plusvic/simplebus2-intercom/remote_unit_v2/cyw43-firmware/README.md

# WiFi + Bluetooth firmware blobs

Firmware obtained from https://github.com/georgerobotics/cyw43-driver/tree/main/firmware

Licensed under the [Infineon Permissive Binary License](./LICENSE-permissive-binary-license-1.0.txt)
