plusvic/simplebus2-intercom/(threads)

Thread 2 (2021-11-08):

PCB

thomasvt1, 2021-11-08:
Hey, this looks awesome! I was just wondering, did you make the PCB yourself or did you create/build/assemble is somewhere?

simplebus2-repeater.kicad_pcb seems to be empty so jlcpcb.com seems to be a no-go

plusvic, 2021-11-08:
I built the PCB using a soldering breadboard, didn't printed a proper PCB.

FilippoPiazza, 2023-01-26:
Can you show the pcb? It's not seen in the pictures

Elektroarzt, 2023-02-05:
If someone is interested, I made an Eval-Board for easy measurement of power and some key signals with an additional connection possibility to a D1 mini. If needed I could upload the Gerber data. If someone has a software solution for a D1 mini or ESP32, I would be grateful to participate and could adapt to the pub design.

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

Elektroarzt, 2023-05-11:
Hi [VideoScape](https://github.com/VideoScape),
please be aware, that this PCB is work in progress and is no plug-and-play solution. If you like to participate in developing, this could be a good starting point. I could send you a unit with schematics for self-cost, please give me an e-mail to handle this. In return I would like to participate in your findings and an ESP-based firmware if you plan to do so.
As plusvif already stated, the linear power supply is not sufficient for the ESP. Not the S2 bus voltage is dropping, but the thermal protection of the linear power regulator. Would be better to use a step-down-converter. The PCB gives you all possibilities for that.

richardneitzke, 2023-05-14:
Hi @Elektroarzt!

Looks like you've already made some progress on the hardware-side, I'm currently looking into building an ESP8266/ESP32-based bridge as well but I just got started (had a look at the signals with my scope today).

My initial plan for drawing power from the bus was to use one of these cheap LM2596 boards I have lying around but connecting one killed the bus (even without drawing any current, maybe it's the capacitor across the input). What do you use for power on your board?

Elektroarzt, 2023-05-16:
Using the linear regulator with the ESP results in brownouts, so I also used a LM2596 but had no issues with the bus at first sight. Did you connect behind the low pass filter like in plusvic's schematic?
I think Gurkenflieger is miles ahead with his ESP development approach: https://github.com/plusvic/simplebus2-intercom/issues/5. Maybe this will be the better path.

Gurkenflieger, 2023-05-23:
![Uploading AC360B84-6A4E-4699-9CF6-66F649A49109.jpeg…]()

Gurkenflieger, 2023-05-23:
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

issalig, 2023-10-04:
@Elektroarzt would you mind to share your pcb/software? My idea is to connect an ESP32 or even a RPIZero to manage the video/audio and not start from zero if possible.

Elektroarzt, 2023-10-04:
I had some really productive and funny hours of teamwork with [Gurkenflieger](https://github.com/Gurkenflieger) on this project. Outcome was a V2.0 of the PCB and a newly coded software for Comelit systems based on [plusvics](https://github.com/plusvic) work. We had the plan of publishing to a GitHub, but had not the time until today. I talked to [Gurkenflieger](https://github.com/Gurkenflieger) concerning the video option. From what we see, this function could be solved in best case with a Piggy-Back on the V2.0 PCBA (see picture J2 and J3). It is populated with a Seeedstu
dio XIAO ESP32C3 wich should be potential enough for this task. Please be patient until we have the time to publish.

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

issalig, 2023-10-04:
It looks great.
The problem to read the video is not the power of a ESP32 (that I think is capable) but to implement CVBS capture, that's why I was thinking on using a rpi zero and usb capturer.
Anyway, I will stay tun

quentinjourdan, 2024-01-09:
> I had some really productive and funny hours of teamwork with [Gurkenflieger](https://github.com/Gurkenflieger) on this project. Outcome was a V2.0 of the PCB and a newly coded software for Comelit systems based on [plusvics](https://github.com/plusvic) work. We had the plan of publishing to a GitHub, but had not the time until today. I talked to [Gurkenflieger](https://github.com/Gurkenflieger) concerning the video option. From what we see, this function could be solved in best case with a Piggy-Back on the V2.0 PCBA (see pin headers J2 and J3 in the following pictures). It is populated with a Seeedstudio XIAO ESP32C3 wich should be potential enough for this task. Please be patient until we have the time to publish.
>
> ![Mittel (Simplebus MQTT Bridge V2 0 Pic4)](https://private-user-images.githubusercontent.com/61664171/272495760-3bd765ca-6ebf-4322-bf2a-cff87bbcb585.jpeg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) ![Mittel (Simplebus MQTT Bridge V2 0 Pic5)](https://private-user-images.githubusercontent.com/61664171/272495755-86c3be73-529c-4ac1-ac80-a8bd9ae055a9.jpeg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) ![Mittel (Simplebus MQTT Bridge V2 0 Pic2)](https://private-user-images.githubusercontent.com/61664171/272495763-15ea2756-d622-4c0f-a23b-1a509d0defcf.jpeg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) ![Mittel (Simplebus MQTT Bridge V2 0 Pic3)](https://private-user-images.githubusercontent.com/61664171/272495762-59028f65-c8ad-4aa8-b1d2-61a8ed68e56d.jpeg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) ![Mittel (Simplebus MQTT Bridge V2 0 Pic1)](https://private-user-images.githubusercontent.com/61664171/272495767-805a1d74-fb70-4405-b2b5-fb315aa98c77.jpeg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)

Incredible @Elektroarzt  @Gurkenflieger, do you plan to release the code/pcb files or kit ? I’m very interested for my appartement

Elektroarzt, 2024-01-11:
> Incredible @Elektroarzt @Gurkenflieger, do you plan to release the code/pcb files or kit ? I’m very interested for my appartement

I'm uploading hardware and mechanics right now to an own GitHub page. What do you need for the start? It's a bit more stuff. In V2.0 of the PCB there was a pinout bug that had to be routed by hand. I made a V2.1 PCB, that I have to test the next days. Therefor I will make a small batch of V2.1 if you are interested in a kit.
Software was coded by @Gurkenflieger, who will upload shortly.

se-bastiaan, 2024-01-12:
> Therefor I will make a small batch of V2.1 if you are interested in a kit.

If you end up doing this, definitely let me know :)

richardneitzke, 2024-01-13:
Same here, I’d love to buy a kit!

Elektroarzt, 2024-01-18:
I don't want to spam this issue. So if you are interested in the above spinoff project, go to [this](https://github.com/Elektroarzt/simplebus2-mqtt-bridge/tree/main) project page. I will open up an issue there for the PCBA to keep you in the loop.
A lot of thanks for the great work so far go to @plusvic!

Closed 2024-01-11.

Thread 3 (2022-03-29):

PIC12F508

pcalabrese, 2022-03-29:
Hi!,
Very helpful and complete protocol description! Congrats!!

I was wondering if the PIC12F508 can be more easily replaced with a ESP8266 or other chip easier to find / program.

I've read about your first prototypes with 433MHz transceiver and/or ESP8266. Could you share more details about?

Still Many Thanks for your great job!

plusvic, 2022-03-30:
Hi, in theory you can replace the PIC12F508 with an ESP8266, but it would a new program for decoding the signal and probably a new circuit. The ESP8266 is a lot more power hungry than the PIC12F508, that's why I ended up using the latter.

My tests with the ESP8266 where very limited, I just tried to power it from the intercom line, but it dropped the voltage too much, so I decided to switch to the PIC12F508. In theory it could be done, as the intercom line is able to power much larger devices with video screens, which require a lot of power, but I'm not an electronics expert didn't know how to do it properly.

Gurkenflieger, 2023-01-21:
Hello, do you still have your code from the ESP testing? I think that the voltage regulater overheats and it could be possible to implement a buck converter to drive an esp.

plusvic, 2023-01-23:
I didn't wrote the code for the ESP, I dropped the idea of using ESP very early in the design phase.

Thread 4 (2022-06-29):

Need some explanation

Elektroarzt, 2022-06-29:
Hi plusvic,

I like to use your fabulous work in a similar project (S2 bus > ESP8266 > Node Red > Apple HomeKit). Now I have some questions, that you maybe can answer:
- the PIC is not available til end of the year in Germany, is it possible to direct replace with a 12f509?
- as I understand, the UART speaks out the codes in your table, so the ESP8266 UART will fit seamless, correct?

Best regards and thanks in advance,
Thomas

plusvic, 2022-06-30:
Hi Thomas,

The only difference between the PIC 12F508 and the 509 is that the latter has more memory, so you can use it without changes in the code.

The UART speaks out the same 18-bits messages transmitted over the bus, including message id, destination address and checksum. Each message is encoded in 3 bytes when transmitted over UART. The transmissions is done at 4800 bauds, so you must configure the ESP8266 to receive at that speed.

You can see how each part of the message is decoded from the 3 bytes received over UART in https://github.com/plusvic/simplebus2-intercom/blob/main/remote_unit/src/main.cpp#L362

You will need an equivalent code for your ESP8266.

Elektroarzt, 2022-09-01:
Would it be possible for you to generate a hex file? I installed the microchip IDE but I'm experiencing lots of problems in compiling the asm file. This would be very helpful, as I am more the hardware guy. I made a PCBA out of your schematic if you or someone else is interested.

Many thanks in advance!

plusvic, 2022-09-06:
I lost the Virtual Machine where I had all the setup for building the code and generating the hex file, it would be very time-consuming for me and don't have too much time to spend on this project anymore.

Closed 2022-09-06.

Thread 5 (2023-01-26):

PIC12F508 Hex file

Gurkenflieger, 2023-01-26:
Is it possible to receive the hex file of the asm programm? PIC Programming is new to me and converting this to an Hex file in order to flash it through a K150 flasher is not straight forward unfortunately.

plusvic, 2023-01-26:
Unfortunately I don't have the hex file around.

Gurkenflieger, 2023-02-03:
Thanks, i managed to power an esp32 with a polulu 5v 1A DC DC converter.

Gurkenflieger, 2023-02-03:
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

plusvic, 2023-02-03:
The trick is measuring the time that elapses from one pin change to the other. You need to measure for how long the pin remains without changes. When that interval is around 17ms you have detected the message preamble. If you see an interval around 3ms without pin changes that's a 0, while 6ms it's a 1.

Shorter intervals, like the ones seen during the 25khz burst, are simply ignored. Every time the pin changes you simply reset the time counter. The important thing about the protocol is the time that elapses without pin changes, that's what you need to measure, and see if the interval fits any of the expected values (17ms, 6ms or 3ms)

Gurkenflieger, 2023-02-07:
Thanks, now i can send and receive messages directly with the esp 32 but if ringing outside i only receive the Acknowledgment pulses without a proper preamble and message. So i’m detecting an outside ring if there was no message and only 3 short pulses .
I think the Intercom activates over the Video, because if i ring with the CFP button (which does not activate the video) i receive the correct corresponding message with the preamble (17 ms pausetime).

Thank you for your previous help!

plusvic, 2023-02-07:
It looks like the signal that arrives to you when someone rings outside is too weak, and falls below the threshold voltage for the LM2903. The LM2903 is acting as a voltage comparator between a fixed voltage of 500mV and the pulses that conform the signal. If the pulses are below 500mV they won't trigger the comparator. When you use the CFP button the signal is generated by your own intercom. That signal is stronger because the source is closer, and the peak voltages are higher. The same happens when you push the "open door" button in the intercom, the signal is very strong because it's generated by the intercom itself.

In the images you posted the signal has peaks around 1.2V, but the message code is "open door", so you probably generated that image by pushing the "open door" button in your home's intercom. If the strong signal coming from the closer intercom has ~1.2V peaks, you can expect the weaker signal coming from the intercom in the street to be way lower,
probably 1/3 of that, or 400mV.

What you can do is replacing either R3 or R4 in the [diagram](https://user-images.githubusercontent.com/182937/119274823-27513a00-bc12-11eb-81a5-44e7b55a2baf.png
) with a potentiometer. The potentiometer will allow you to adjust the voltage at pin 2 of LM2903, in your case you need to make the voltage lower, probably around 250-300mV. You don't want go too low neither, because then your signal will be affected by noise in the line.

You can try to capture with the oscilloscope the signal generated when someone rings outside, in order to be able to measure the peaks in a the signal. Of your may find the appropriate threshold voltage by trial and error, lowering the voltage a little bit until your device is able to see the signal.

Gurkenflieger, 2023-02-08:
Thanks, that helped! I used a 6k8 R4 and i can now see the ring on my oszi and in my application. Thanks alot. I also put a high pass filter on the input of the NPN transistor to prevent a long short on the bus. I have seen this on an other implementation of the simplebus 1 protocol.

plusvic, 2023-02-08:
Great! The high pass filter looks like a great design improvement. If I understand correctly you put a capacitor in between R5 and Q1, right?

Gurkenflieger, 2023-02-08:
I put the same values as C3 and R2 from the controller output to GND. Between the capacity and resistor the transistor is connected. I think if C3 and R2 are passing through the 25khz signal the values should be fine.

plusvic, 2023-02-10:
As long as you are getting a stable DC voltage at the output of the 7805 it should be fine. You can also increase the capacity of C1, that should compensate the decrease of R1.

Elektroarzt, 2023-05-11:
> I also noticed some brownouts, but the problem was the resistor value of the low pass filter. This resistor was getring pretty hot. I exchanged it for a 2.2 Ohm Resistor to minimize the voltage drop and heat buildup. With the 510 Ohm resistor and 3W power consumption of the esp, the voltage drop was massive. But the filtering is now a little worse. But still the values should filter all signals above 300Hz. What do you think ?

Gurkenflieger, do you have the described solution up and running for outside / inside ringing in your setup with ESP32?

Gurkenflieger, 2023-05-13:
Yes but i put  diode in instead of an resistor and im using 3.3V for the more efficient supply. The ESP 32 works and has no brownouts but the reference voltage of the comparator drops and therefore i cant detect a outside ring. I have to get a better scope to fix this. I also have some PCBS made for this application which fit under the intercom in the 68mm hole.
My Code works perfectly if i supply the ESP32 Externally. But at the moment my time is limited and i will rework on this in the near future.
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

Gurkenflieger, 2023-05-16:
> > I also noticed some brownouts, but the problem was the resistor value of the low pass filter. This resistor was getring pretty hot. I exchanged it for a 2.2 Ohm Resistor to minimize the voltage drop and heat buildup. With the 510 Ohm resistor and 3W power consumption of the esp, the voltage drop was massive. But the filtering is now a little worse. But still the values should filter all signals above 300Hz. What do you think ?
>
> Gurkenflieger, do you have the described solution up and running for outside / inside ringing in your setup with ESP32?

So after my initial feedback i just bought a new oscilloscope with way more memory and im able to debug the system in the coming weeks. Will post my results and my schematics.

Elektroarzt, 2023-05-16:
Your board looks awesome, nice idea to put it in the junction box. Would be happy to hear from your findings :)

issalig, 2023-10-04:
> So after my initial feedback i just bought a new oscilloscope with way more memory and im able to debug the system in the coming weeks. Will post my results and my schematics.

@Gurkenflieger , is it possible for you to share your code and pcb? I want to do the same and it would save me a lot of time. No matter if I need to power it externally.

Thread 7 (2023-05-24):

Audio/Video protocol

gizahNL, 2023-05-24:
Do you have a description of the A/V protocol that is used on simplebus2? Would be really cool to hack together a device that can hook into the A/V stream & relay it onto my network.

plusvic, 2023-05-25:
The A/V signal is analog, not digital. It looks like some kind of [composite video](https://en.wikipedia.org/wiki/Composite_video), but I'm not sure whether its PAL, NTSC or SECAM. My expertise in that area is close to null. I had the idea of decoding the A/V signal too, but after some investigation I concluded that my knowledge about analog electronics is too limited for such undertake. If anyone with more experience can make some progress on that it would be great.

plusvic, 2023-05-25:
See #6.

issalig, 2023-10-02:
I was able to see the image with just a cheap USB video capturer. You only need gnd and as far as i remember the composite signal is the yellow cable that goes to the screen.

plusvic, 2023-10-03:
@issalig that's very interesting, can you share more details about your setup?

issalig, 2023-10-03:
I have re-opened the intercom and yes, it is the yellow cable that goes to the CVBS in the pcb silkscreen.
Upper left connector
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

morganflint, 2024-03-29:
Hello, great project!
I understand capturing and streaming the video with cheap devices like ESP32 might be nearly impossible but, what about just audio?
It must be possible to do it directly from the simplebus2 signal, as the Ring device does (bilateral)... but maybe the associated hardware isn't simple

Elektroarzt, 2024-03-29:
Hi ... for the basic communication part of the S2 bus except audio / video we have a solution, but audio would be very interesting. Here is a [link to an issue of a spinoff project](https://github.com/Elektroarzt/simplebus2-mqtt-bridge/issues/3), where sashahilton00 documented his investigations concerning audio so far. Maybe it helps or is a start.

Thread 8 (2023-10-03):

Board headers

issalig, 2023-10-03:
I have detected this headers in the board J5 that looks an I2C bus and J5 for mcu programming.
It would be interesting to explore J5.

Also, I am thinking if TP12 and TP13 Rx and TX would show the  messages in 0-5V

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

mmhobi7, 2024-07-26:
Any updates?

Thread 9 (2023-11-25):

Capacitors types and values

prtngrm, 2023-11-25:
Hi,
I would like to make this project but I'm not an electronic expert.
Could someone tell what is the type and voltage values of each capacitor?

Also which type of diodes for the full bridge rectifier?

plusvic, 2023-11-25:
C1 and C2 are electrolytic capacitors, C3 is a ceramic capacitor.

Values are in the [schematic](https://user-images.githubusercontent.com/182937/119274823-27513a00-bc12-11eb-81a5-44e7b55a2baf.png)

C1 = 150 microF
C2 = 220 microF
C3 = 100 nanoF

For the diodes the 1N4001 or 1N4002 should work fine.

prtngrm, 2023-12-05:
Thanks !

Closed 2023-11-25.

Thread 10 (2024-02-02):

Irrelevant data received

prtngrm, 2024-02-02:
Hi,
I made the repeater based on the schematic. For the remote unit I use an esp32.
At first I wasn't receiving anything. Then I tweaked the remote unit code to print all messages and that worked except that the message codes wasn't like yours and the checksum received didn't match the calculated one.
I was on a breadboard so I soldered the repeater on a perf board but that didn't solve the problem.
I tried to make my intercom ring with a button for the test with no luck.
Here is an example of what I have with the calculated checksum and the received:
```
RX <- code: 191 address: 254 checksum: 14 checksum received: 15
RX <- code: 191 address: 14 checksum: 10 checksum received: 0
RX <- code: 246 address: 15 checksum: 10 checksum received: 0
RX <- code: 255 address: 15 checksum: 12 checksum received: 0
RX <- code: 2 address: 0 checksum: 1 checksum received: 0
RX <- code: 0 address: 232 checksum: 4 checksum received: 15
RX <- code: 3 address: 0 checksum: 2 checksum received: 0
RX <- code: 191 address: 14 checksum: 10 checksum received: 14
RX <- code: 163 address: 254 checksum: 11 checksum received: 14
RX <- code: 191 address: 142 checksum: 11 checksum received: 14
RX <- code: 3 address: 0 checksum: 2 checksum received: 0
RX <- code: 3 address: 12 checksum: 4 checksum received: 14
RX <- code: 254 address: 15 checksum: 11 checksum received: 0
RX <- code: 248 address: 31 checksum: 10 checksum received: 12
RX <- code: 255 address: 15 checksum: 12 checksum received: 0
RX <- code: 2 address: 0 checksum: 1 checksum received: 0
RX <- code: 191 address: 14 checksum: 10 checksum received: 14
RX <- code: 131 address: 254 checksum: 10 checksum received: 14
RX <- code: 191 address: 142 checksum: 11 checksum received: 14
RX <- code: 3 address: 0 checksum: 2 checksum received: 0
RX <- code: 3 address: 0 checksum: 2 checksum received: 0
RX <- code: 132 address: 14 checksum: 5 checksum received: 0
RX <- code: 0 address: 20 checksum: 2 checksum received: 14
RX <- code: 132 address: 14 checksum: 5 checksum received: 0
RX <- code: 135 address: 10 checksum: 6 checksum received: 0
RX <- code: 131 address: 254 checksum: 10 checksum received: 14
RX <- code: 191 address: 14 checksum: 10 checksum received: 14
RX <- code: 131 address: 254 checksum: 10 checksum received: 14
RX <- code: 138 address: 10 checksum: 5 checksum received: 0
RX <- code: 3 address: 0 checksum: 2 checksum received: 0
RX <- code: 11 address: 12 checksum: 5 checksum received: 0
RX <- code: 144 address: 14 checksum: 5 checksum received: 0
RX <- code: 191 address: 142 checksum: 11 checksum received: 14
RX <- code: 131 address: 254 checksum: 10 checksum received: 14
RX <- code: 191 address: 14 checksum: 10 checksum received: 14
RX <- code: 3 address: 0 checksum: 2 checksum received: 0
RX <- code: 154 address: 10 checksum: 6 checksum received: 0
RX <- code: 155 address: 10 checksum: 7 checksum received: 0
RX <- code: 25 address: 108 checksum: 7 checksum received: 14
RX <- code: 191 address: 142 checksum: 11 checksum received: 14
RX <- code: 131 address: 254 checksum: 10 checksum received: 14
RX <- code: 191 address: 142 checksum: 11 checksum received: 14
RX <- code: 3 address: 0 checksum: 2 checksum received: 0
```

When I call from the building:
```
RX <- code: 84 address: 5 checksum: 5 checksum received: 0
RX <- code: 150 address: 10 checksum: 6 checksum received: 0
RX <- code: 255 address: 15 checksum: 12 checksum received: 14
RX <- code: 131 address: 254 checksum: 10 checksum received: 14
RX <- code: 191 address: 14 checksum: 10 checksum received: 0
```
My address is 5.

plusvic, 2024-02-03:
It's hard to say what's happening there. Without an oscilloscope that allows you to see if the signal you are receiving is ok, you will have a hard time debugging this.

Thread 11 (2024-11-29):

Opening a secondary entrance door

m4rcu5, 2024-11-29:
On my Comelit intercom I can control multiple doors. Without the screen turned on, hotting the "open" button wil open the primary entrance. However if I cycle through the camera feeds by pressing "1", I can open the secondary entrance when its in view by pressing the same "open" button.
Does anyone have experience with the codes this spits out?

I haven't build a module yet, as I was hoping for some experiences first, but otherwise I'll just go build, play, and report back :)

plusvic, 2024-11-29:
In my case it's very similar, but only with two doors. The codes for opening each door is the same regardless of the door you are opening. The intercom in your house simply sends the "open door" message through the wire, and the door intercom that is active at that moment is the one that actuates and opens the door asigned to it. The rest of the doors receive the message too, but they don't open their door because they are not active at that moment.

m4rcu5, 2024-11-30:
That interesting! In my case, I have a Comelit 6701W, where button "2" (sorry mistyped in the original message) is set to "self activation". If you press it, it will activate the camera/mic of the main entrance. And when pressed again cycles to the next door.

So I suspect that this "activates" the door, which will then listen to the "open" call. As far as I understand the system, the video signal is analog, and therefore allows only a single intercom to be active at the same time.

The use-case of responding to a call by opening the door would work out of the box. But my use-case would be more the other way around, opening the door from my phone, as a way of key-less entry.

Taken that the secondary door was added at a later stage, and did not require reconfiguration of my unit, I don't see the indoor unit send a addressed call to it directly. Meaning the button would send some sort of "cycle" code?
I did notice, it will always start with the first door when pressing the "self-activate", and just continue to cycle when pressed.

Is there a way to monitor for the raw codes send on the line?

plusvic, 2025-02-01:
@m4rcu5 I just discovered the answer to your question by accident. The secondary door is activated my sending the "camera on" (code 20) message twice in a short interval (around 1s). I guess that if you have a third camera it could be activated by sending the message 3 times in short intervals.

m4rcu5, 2025-02-05:
> [@m4rcu5](https://github.com/m4rcu5) I just discovered the answer to your question by accident. The secondary door is activated my sending the "camera on" (code 20) message twice in a short interval (around 1s). I guess that if you have a third camera it could be activated by sending the message 3 times in short intervals.

Thanks for testing! I take it you need send the code 20 twice, followed by the 'door open' code. I'll start gathering some hardware and build the circuit to test :)

Thread 12 (2025-01-15):

Display gray scale in colour monitor.

polpas, 2025-01-15:
Hi there,

I have a monochrome 5801 monochrome device aka b&w. I installed an 6721w but having image interference. Does anyone know if I can apply any kind of filter so image does not get with interference?

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
