plusvic/simplebus2-intercom/repeater/pcb/simplebus2-repeater.kicad_pcb

## KiCad design sensor_node_PCB/sensor_node_PCB.kicad_pcb


Parts:
C1, C5: 0.1 uF; C_0603_1608Metric
C2, C4: 47uF; C_0603_1608Metric
C3, C10: 1uF; C_0603_1608Metric
C6: 4.7uF; C_0603_1608Metric
C12, C13: C_Small; C_0603_1608Metric
D1: DIODE; D_SOD-123
D2: LED; LED_0603_1608Metric
F1: Polyfuse; Fuse_1206_3216Metric
J1: USB_B_Mini; USB_Mini-B_Tensility_54-00023_Vertical
J3: OUTPUT_CONNECTOR; PhoenixContact_MSTB_2,5_4-GF-5,08_1x04_P5.08mm_Horizontal_T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
P1: BREAKOUTS; TerminalBlock_bornier-6_P5.08mm
Q1: FDN340P; SuperSOT-3
Q2, Q3: BSS138; SOT-23
R1, R2, R6, R7, R8, R9: 10K; R_0603_1608Metric
R3: 510; R_0603_1608Metric
R4, R5: 27R; R_0603_1608Metric
R10: 1k; R_0603_1608Metric
U1: LMV358IDGKR; SOIC-8_3.9x4.9mm_P1.27mm
U2: LD1117S50TR; SOT-223-3_TabPin2
U4: LM1117-3.3; SOT-223-3_TabPin2
U6: SP485EEN-L_TR; SOIC-8_3.9x4.9mm_P1.27mm
U7: sensair_s8; senseair_s8_v3
U8: BME280; Bosch_LGA-8_2.5x2.5mm_P0.65mm_ClockwisePinNumbering
U9: sht20; DFN-6-1EP_3x3mm_P1mm_EP1.5x2.4mm
U10: dps310; Bosch_LGA-8_2x2.5mm_P0.65mm_ClockwisePinNumbering

Connections:
3V3_LDO: C6.1, C10.1, Q2.1 (G), Q3.1 (G), R6.1, R7.1, U1.2 (-), U4.2 (VO), U8.2 (CSB), U8.6 (VDDIO), U8.8 (VDD), U9.5 (VDD), U10.6 (VDDIO), U10.8 (VDD)
5V_LDO: C1.2, C3.1, C4.1, C5.1, P1.1, Q1.2 (S), R3.2, R8.1, R9.1, U1.8 (V+), U2.2 (VO), U4.3 (VI), U6.8 (VCC), U7.1 (G+(5V)); also elsewhere on the board
12V_BUS: D1.2 (A), J3.4
/ARD_RX1: U6.1 (RO); also elsewhere on the board
/ARD_RX2: U7.7 (UART_TxD); also elsewhere on the board
/ARD_SCL: Q2.3 (D), R8.2; also elsewhere on the board
/ARD_SCL_3V3: Q2.2 (S), R6.2, U8.4 (SCK), U9.6 (SCL), U10.4 (SCK)
/ARD_SDA: Q3.3 (D), R9.2; also elsewhere on the board
/ARD_SDA_3V3: Q3.2 (S), R7.2, U8.3 (SDI), U9.1 (SDA), U10.3 (SDI)
/ARD_TX1: U6.4 (DI); also elsewhere on the board
/ARD_TX2: U7.6 (UART_RxD); also elsewhere on the board
/MODBUS_A-: J3.3, U6.6 (A)
/MODBUS_B+: J3.2, U6.7 (B)
/RS485_LINE_EN!: U6.2 (*RE), U6.3 (DE); also elsewhere on the board
/USB_D+: R4.1; also elsewhere on the board
/USB_D-: R5.1; also elsewhere on the board
/atmega328p/ARD_AN0: P1.6; also elsewhere on the board
/atmega328p/ARD_DIG6: P1.5; also elsewhere on the board
/atmega328p/ARD_DIG7: P1.4; also elsewhere on the board
/atmega328p/ARD_DIG9: P1.3; also elsewhere on the board
GND: C1.1, C2.2, C3.2, C4.2, C5.2, C6.2, C10.2, C12.2, C13.2, D2.1 (K), J1.5 (GND), J1.6 (Shield), J3.1, P1.2, R2.1, U1.4 (V-), U2.1 (GND), U4.1 (GND), U6.5 (GND), U7.2 (G0(GND)), U8.1 (GND), U8.5 (SDO), U8.7 (GND), U9.2 (Vss), U9.7 (NC_3), U10.1 (GND), U10.7 (GND); also elsewhere on the board
unnamed 32: C12.1, C13.1, R10.1; also elsewhere on the board
unnamed: D2.2 (A), R3.1
unnamed: F1.2, J1.1 (VBUS)
unnamed: J1.2 (D-), R5.2
unnamed: J1.3 (D+), R4.2
unnamed: Q1.1 (G), U1.1
unnamed: R1.1, R2.2, U1.3 (+)
unnamed 41: R10.2; also elsewhere on the board
USBVCC: F1.1, Q1.3 (D)
Vin: C2.1, D1.1 (K), R1.2, U2.3 (VI)


Parts:
C7, C11: 0.1 uF; C_0603_1608Metric
C8, C9: 18pF; C_0603_1608Metric
D3: LED; LED_0603_1608Metric
D7: 1N4148W-7-F; D_SOD-123
ICSP2: M20-9980346; PinHeader_2x03_P2.54mm_Vertical_SMD
R11: R_Small; LED_0603_1608Metric
R12: 1K; R_0603_1608Metric
R13: 0; R_0603_1608Metric
R16: 10K; R_0603_1608Metric
U5: ATmega328P-AU; TQFP-32_7x7mm_P0.8mm
Y1: Crystal; Crystal_SMD_5032-2Pin_5.0x3.2mm

Connections:
5V_LDO: D7.2 (A), ICSP2.2, R16.2, U5.4 (VCC), U5.6 (VCC), U5.18 (AVCC); also elsewhere on the board
328P_ICSP_MISO: ICSP2.1, U5.16 (PB4)
328P_ICSP_MOSI: ICSP2.4, U5.15 (PB3)
328P_ICSP_SCK: ICSP2.3, U5.17 (PB5)
/ARD_RX1: U5.32 (PD2); also elsewhere on the board
/ARD_RX2: U5.2 (PD4); also elsewhere on the board
/ARD_SCL: U5.28 (PC5); also elsewhere on the board
/ARD_SDA: U5.27 (PC4); also elsewhere on the board
/ARD_TX1: U5.1 (PD3); also elsewhere on the board
/ARD_TX2: U5.9 (PD5); also elsewhere on the board
/RS485_LINE_EN!: U5.12 (PB0); also elsewhere on the board
/ard_DTR: C11.1, R12.1; also elsewhere on the board
/ard_rx: U5.30 (PD0); also elsewhere on the board
/ard_tx: U5.31 (PD1); also elsewhere on the board
/atmega328p/ARD_AN0: U5.23 (PC0); also elsewhere on the board
/atmega328p/ARD_DIG6: U5.10 (PD6); also elsewhere on the board
/atmega328p/ARD_DIG7: U5.11 (PD7); also elsewhere on the board
/atmega328p/ARD_DIG9: U5.13 (PB1); also elsewhere on the board
/atmega328p/RESET: D7.1 (K), ICSP2.5, R13.2, R16.1, U5.29 (~RESET~/PC6)
GND: C7.2, C8.1, C9.1, D3.1 (K), ICSP2.6, R12.2, U5.3 (GND), U5.5 (GND), U5.21 (GND); also elsewhere on the board
unnamed: C7.1, U5.20 (AREF)
unnamed: C8.2, U5.7 (XTAL1/PB6), Y1.1
unnamed: C9.2, U5.8 (XTAL2/PB7), Y1.2
unnamed: C11.2, R13.1
unnamed: D3.2 (A), R11.1
unnamed: R11.2, U5.25 (PC2)


Board: 2 copper layers, 97.8 x 49.0 mm, 50 parts (0 on the bottom side), 44 nets.

Other parts of the board:
U3: CP2102N-A01-GQFN28; QFN-28-1EP_5x5mm_P0.5mm_EP3.35x3.35mm

Their connections:
5V_LDO: U3.7, U3.8; also elsewhere on the board
/USB_D+: U3.4; also elsewhere on the board
/USB_D-: U3.5; also elsewhere on the board
/ard_DTR: U3.28; also elsewhere on the board
/ard_rx: U3.26; also elsewhere on the board
/ard_tx: U3.25; also elsewhere on the board
GND: U3.3, U3.29; also elsewhere on the board
unnamed 32: U3.6; also elsewhere on the board
unnamed 41: U3.9; also elsewhere on the board
