plusvic/simplebus2-intercom/(commit log)

2021-05-23 Commit repeater's schematic and code.
    [simplebus2-repeater.kicad_pcb, simplebus2-repeater.sch]
2021-05-23 Fix bug in repeater's diagram.
    [simplebus2-repeater.sch]
2023-07-30 Add buzzer.
    A simple Rust program for the ATtiny13 MCU that sends message 21 (MSG_CALL_FROM_FLOOR_DOOR) to the repeater using a HC-12 transceiver. Also contains the Kicad files for the hardware.
    [buzzer-B_Cu.gbr, buzzer-B_Mask.gbr, buzzer-B_Paste.gbr, buzzer-B_Silkscreen.gbr, buzzer-Edge_Cuts.gbr, buzzer-F_Cu.gbr, buzzer-F_Mask.gbr, buzzer-F_Paste.gbr]
2024-12-27 Minor changes to buzzer.
    [main.rs]
2024-12-27 Add repeater v2
    [repeater_v2-B_Cu.gbl, repeater_v2-B_Mask.gbs, repeater_v2-B_Paste.gbp, repeater_v2-B_Silkscreen.gbo, repeater_v2-Edge_Cuts.gm1, repeater_v2-F_Cu.gtl, repeater_v2-F_Mask.gts, repeater_v2-F_Paste.gtp]
2024-12-27 Add remote unit v2
    [remote_unit_v2.kicad_pcb, remote_unit_v2.kicad_sch]
2024-12-27 Add repeater PCB files.
    [simplebus2-repeater.kicad_pcb, simplebus2-repeater.kicad_sch, simplebus2-repeater.sch]
2025-01-25 Fix bug while decoding messages.
    [main.rs]
